DarioCapu/6610_proyecto/Proteus/Clase B/ClaseB_PCB.png

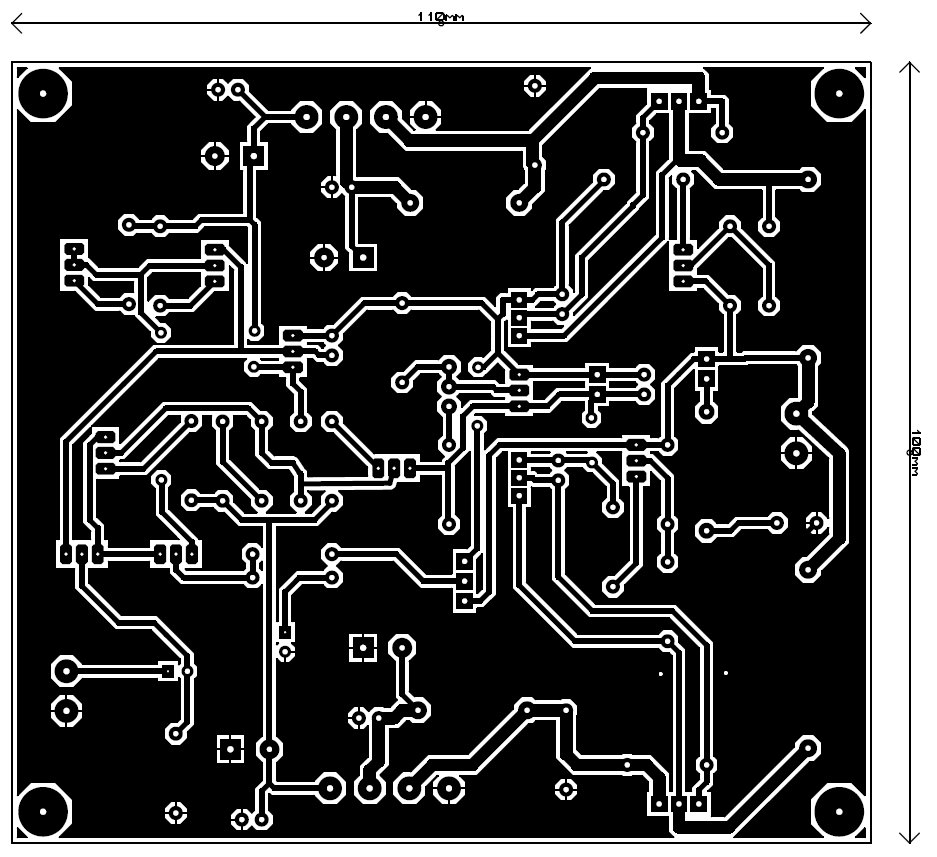
Proteus/Clase B/ClaseB_PCB.png
