DarioCapu/6610_proyecto/Proteus/Clase B/ClaseB_v4.bmp

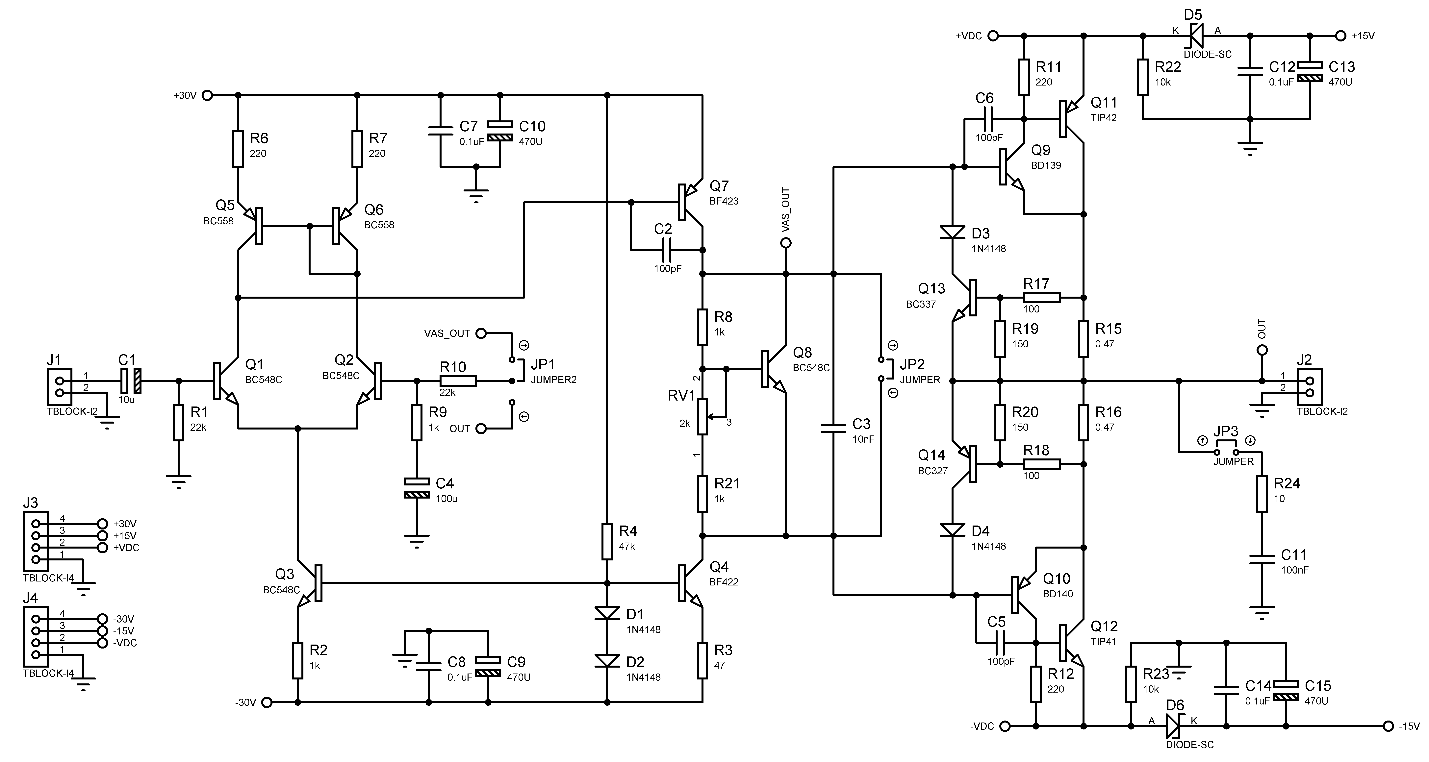
Proteus/Clase B/ClaseB_v4.bmp
