DarioCapu/6610_proyecto/Proteus/Regulador/Regulador_circuito.bmp

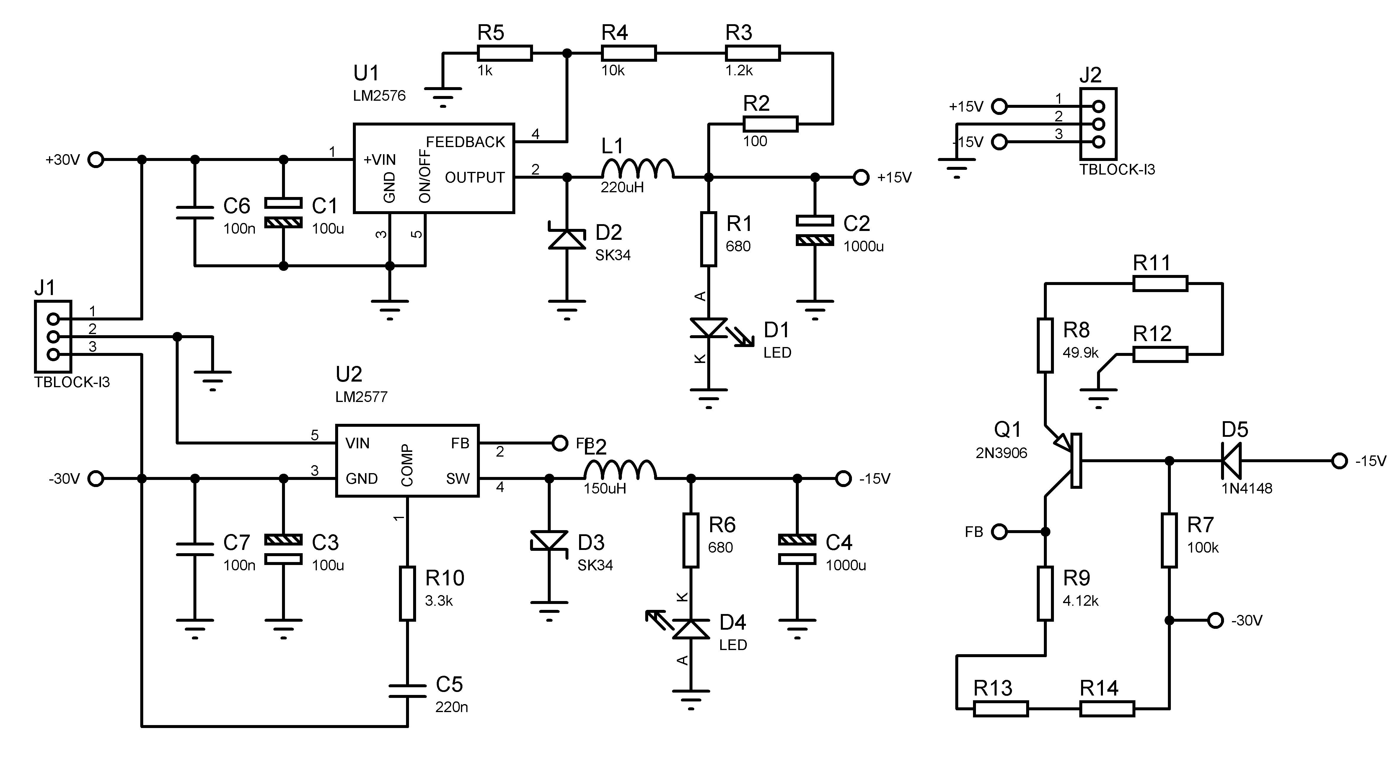
Proteus/Regulador/Regulador_circuito.bmp
