DarioCapu/6610_proyecto/Simulaciones/03_Clase_B_op.png

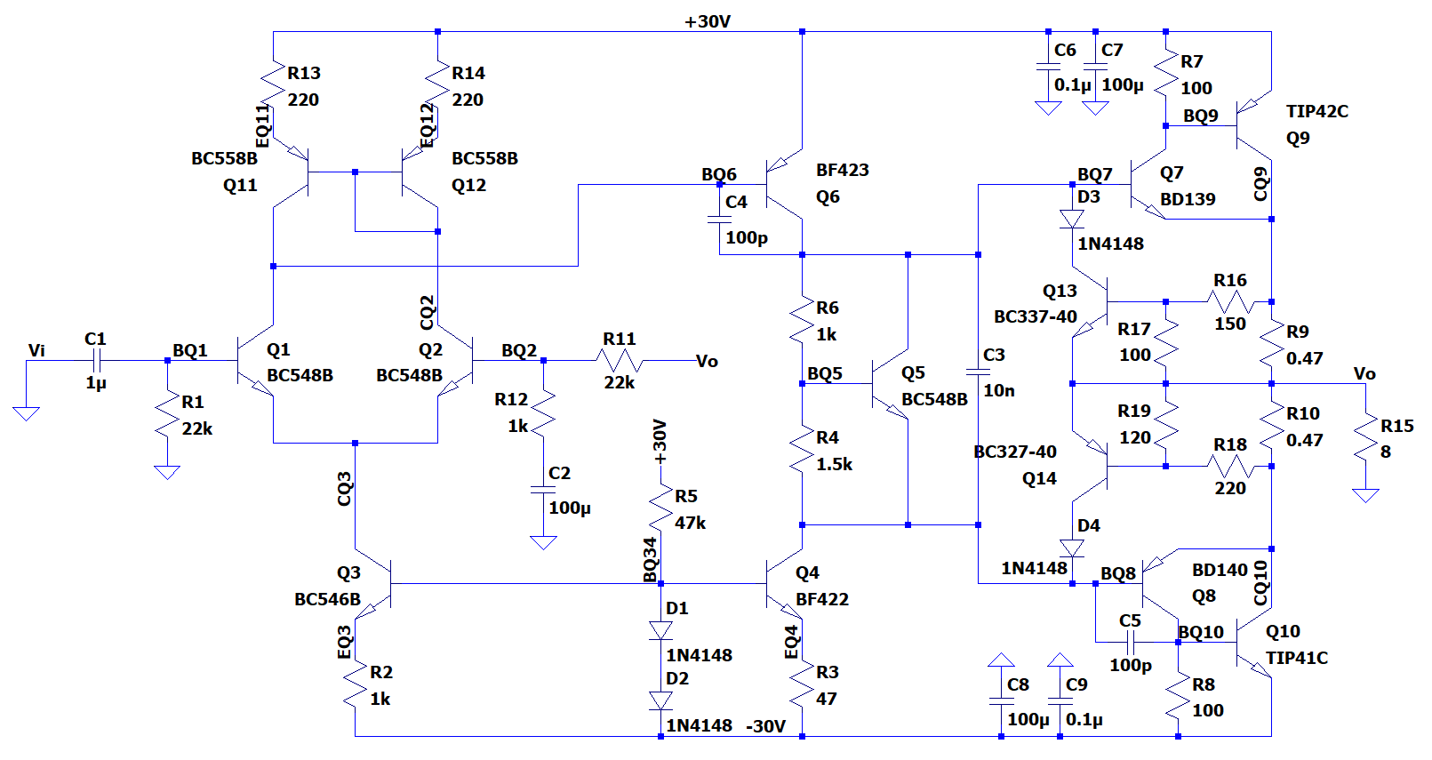
Simulaciones/03_Clase_B_op.png
