DarioCapu/6610_proyecto/Simulaciones/04_Sen_10mV_1kHz.png

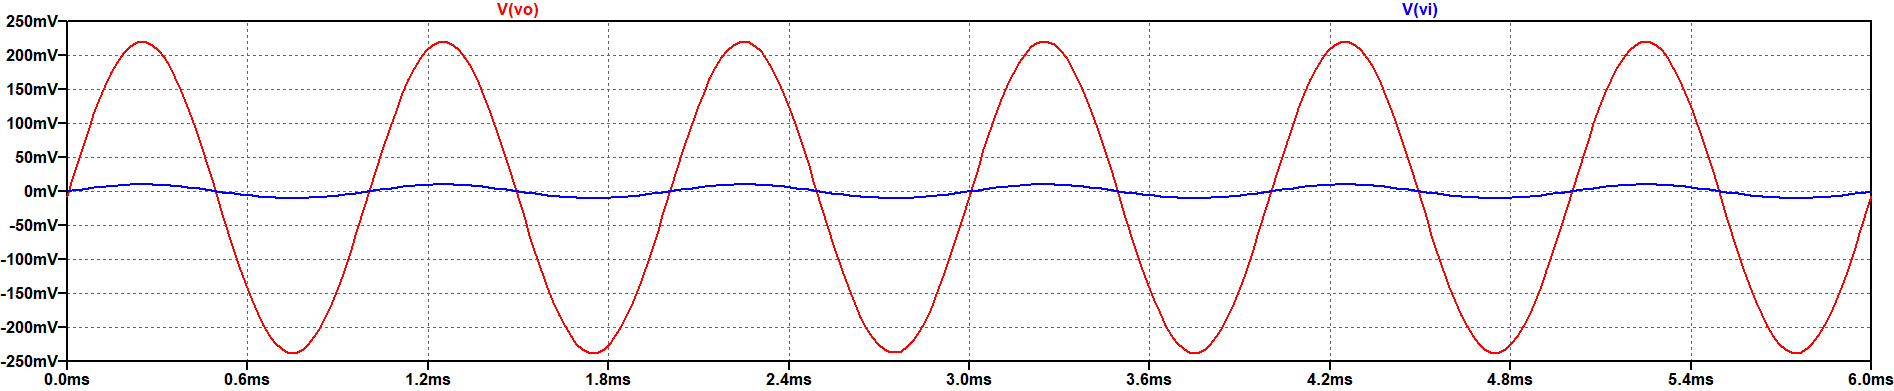
Simulaciones/04_Sen_10mV_1kHz.png
