DarioCapu/6610_proyecto/Simulaciones/10_Cuad_10mV_1kHz.png

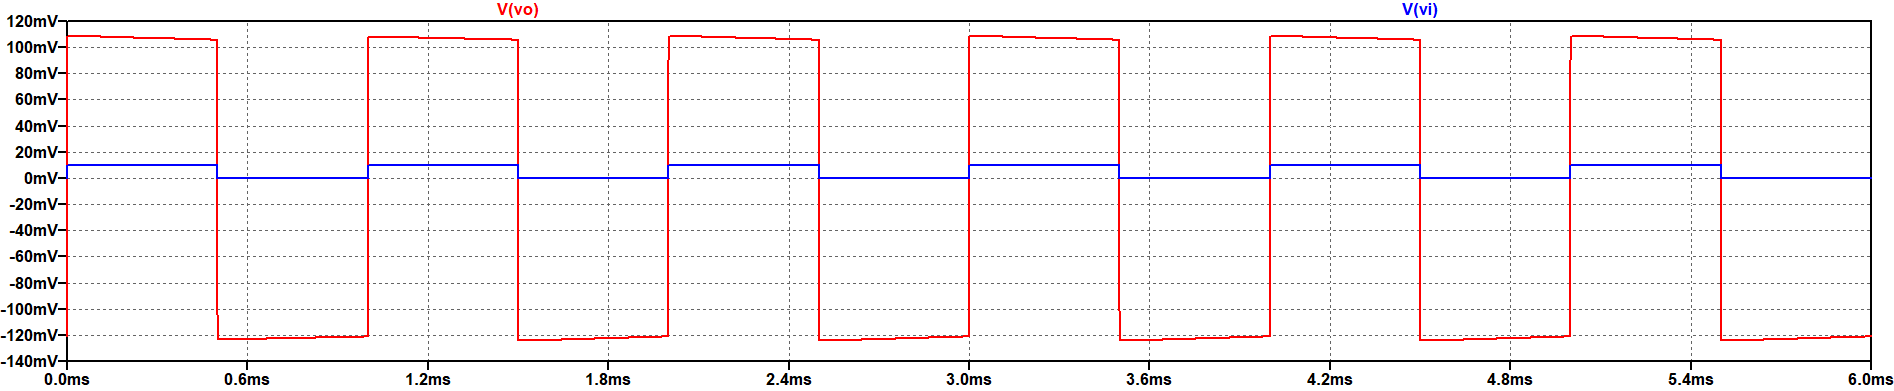
Simulaciones/10_Cuad_10mV_1kHz.png
