DarioCapu/6610_proyecto/Simulaciones/16_BW_clase_B.png

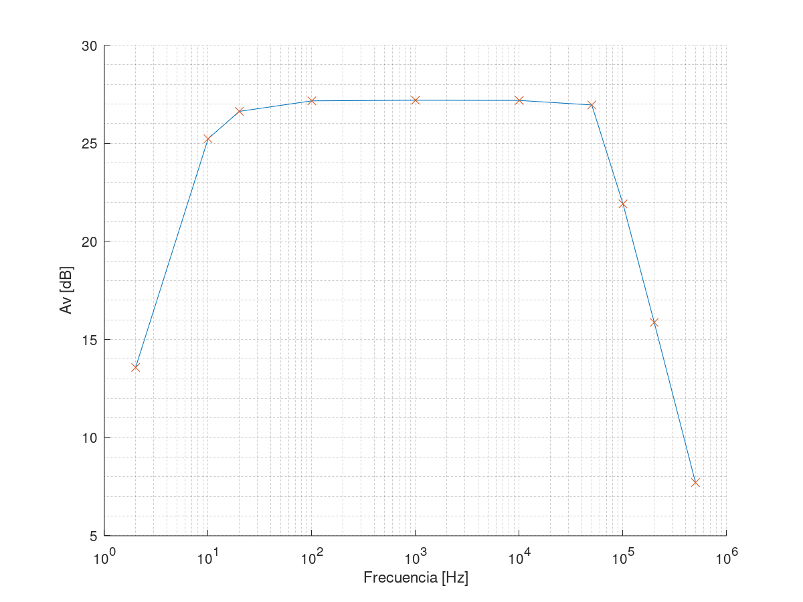
Simulaciones/16_BW_clase_B.png
