DarioCapu/6610_proyecto/Simulaciones/17_Ri_simulada.png

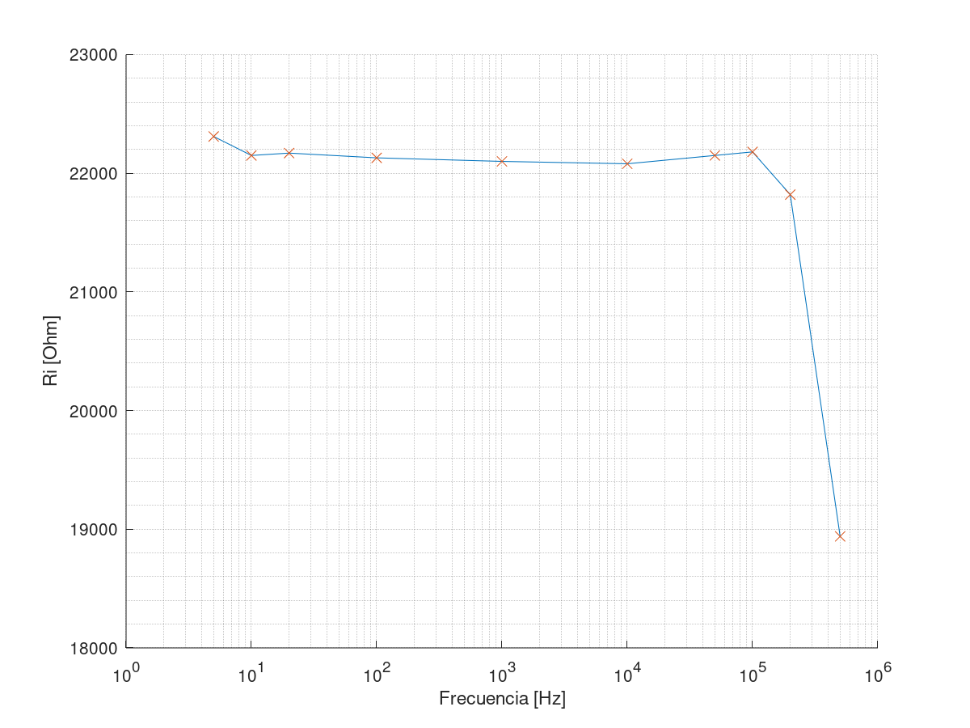
Simulaciones/17_Ri_simulada.png
