DarioCapu/6610_proyecto/Simulaciones/18_Ro_simulada.png

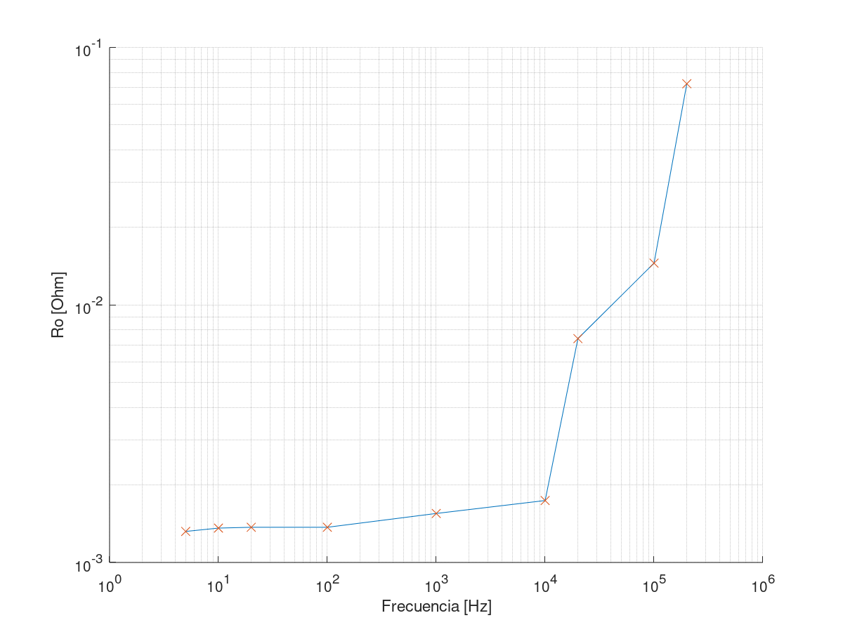
Simulaciones/18_Ro_simulada.png
