DarioCapu/6610_proyecto/Simulaciones/19_THD_simulada.png

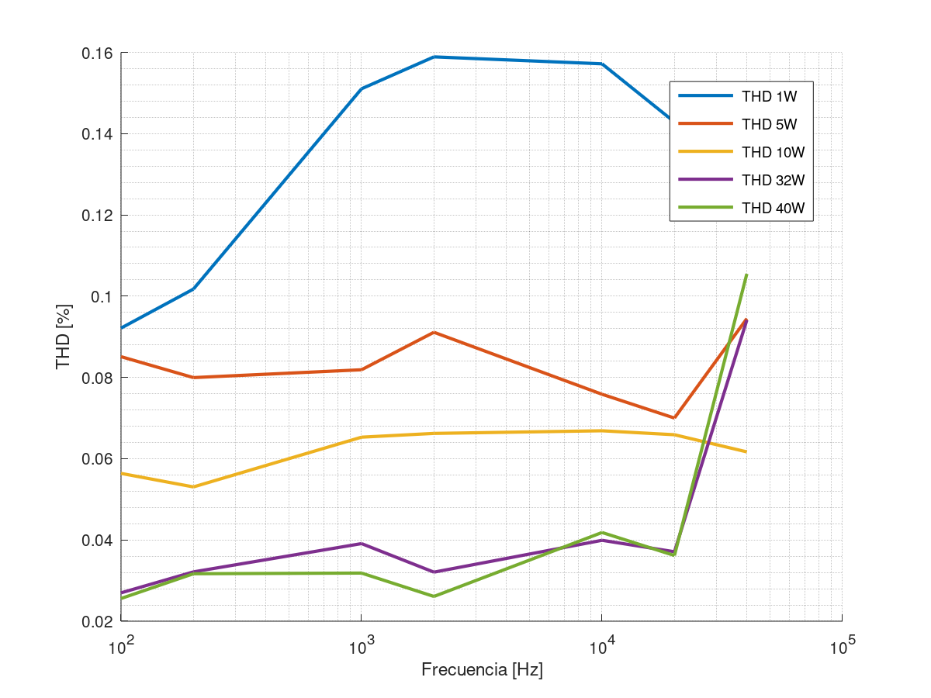
Simulaciones/19_THD_simulada.png
