DarioCapu/6610_proyecto/Simulaciones/30_vo_sin_recorte.png

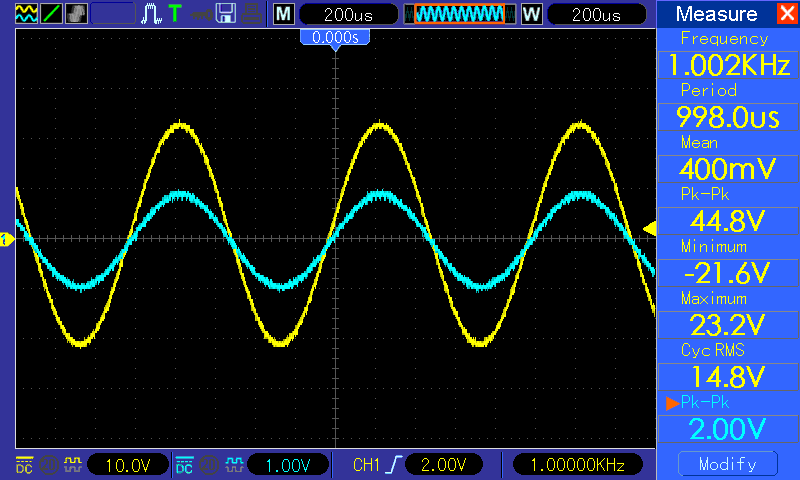
Simulaciones/30_vo_sin_recorte.png
