DarioCapu/6610_proyecto/Simulaciones/31_vo_con_recorte.png

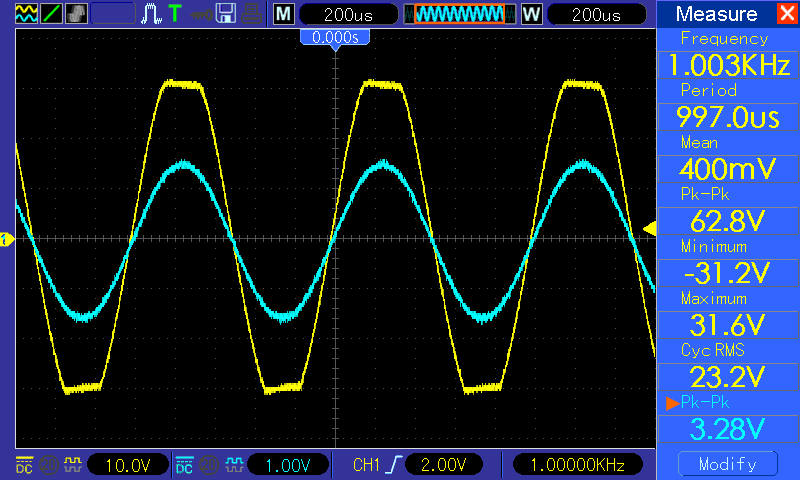
Simulaciones/31_vo_con_recorte.png
