DarioCapu/6610_proyecto/Simulaciones/34_Ganancia_medida_1.png

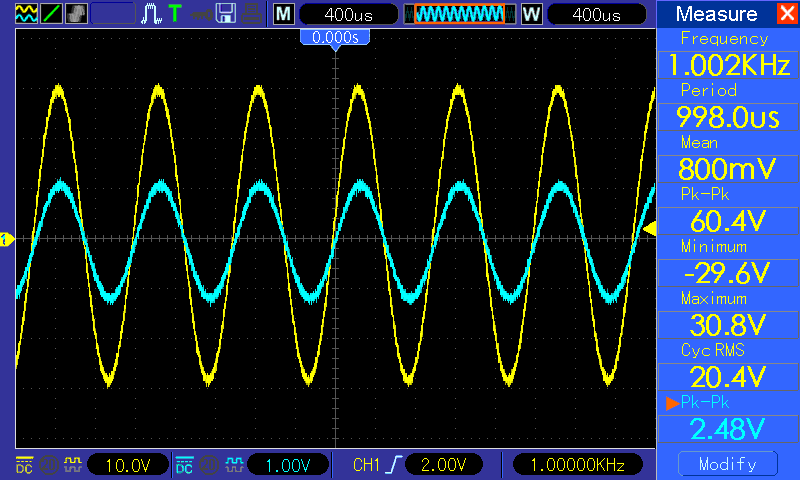
Simulaciones/34_Ganancia_medida_1.png
