DarioCapu/6610_proyecto/Simulaciones/70_Regulador_PCB.png

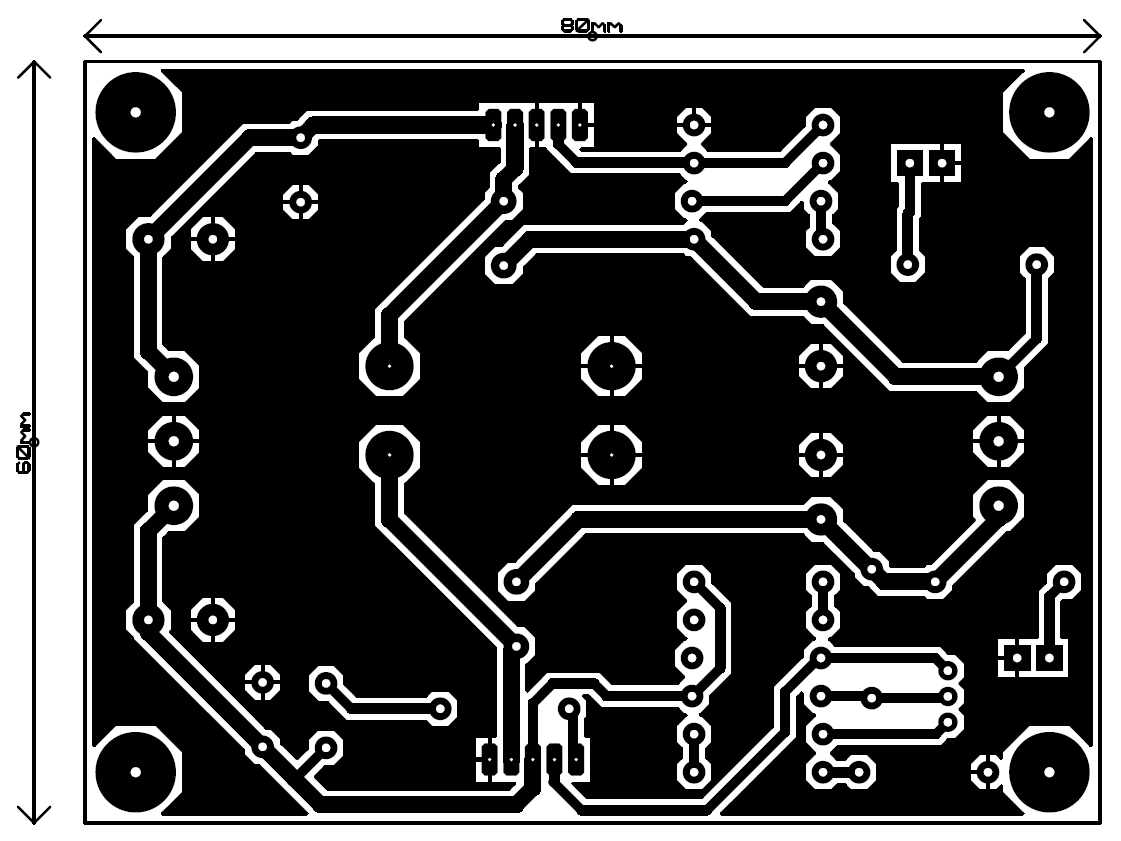
Simulaciones/70_Regulador_PCB.png
