DarioCapu/6610_proyecto/Proteus/Clase B/ClaseB_v4_PCB.PDF

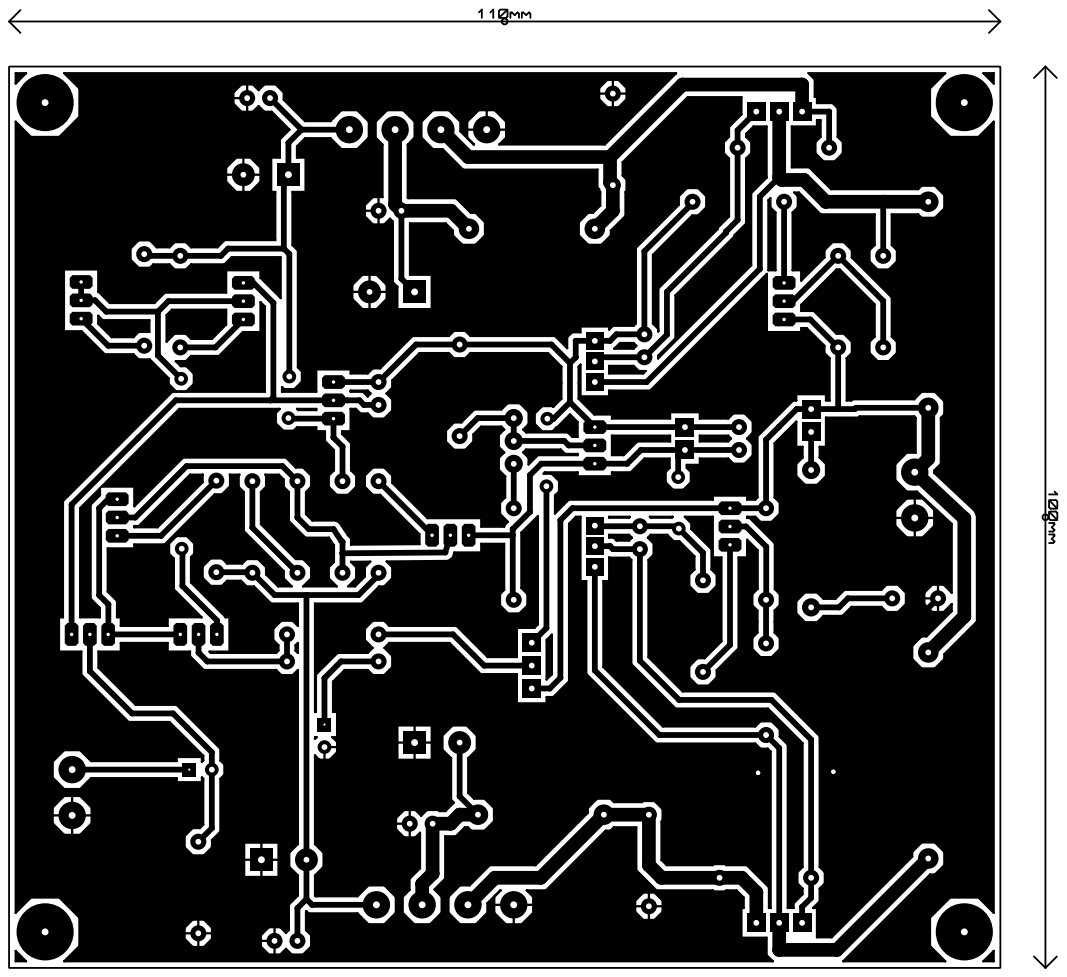
[picture p16: page 1]
