DarioCapu/6610_proyecto/Proteus/Regulador/Regulador.PDF

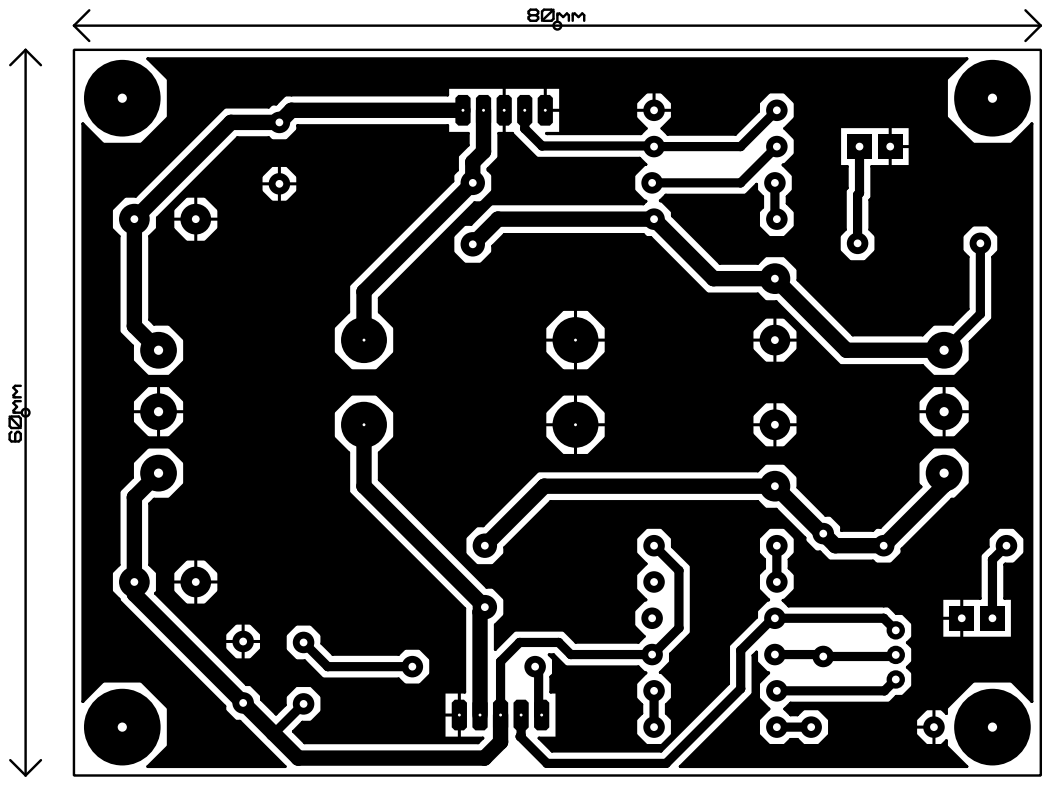
[picture p17: page 1]
