DarioCapu/6610_proyecto/Spice/ClaseB/Clase_B_v3.asc

C1: cap; 10µ
C2: cap; 100µ
C3: cap; 10n
C4: cap; 100p
C5: cap; 100p
C6: cap; 0.1µ
C7: cap; 100µ
C8: cap; 100µ
C9: cap; 0.1µ
D1: diode; 1N4148
D2: diode; 1N4148
D3: diode; 1N4148
D4: diode; 1N4148
Q1: npn; BC548B
Q2: npn; BC548B
Q3: npn; BC546B
Q4: npn; BF422
Q5: npn; BC548B
Q6: pnp; BF423
Q7: npn; BD139
Q8: pnp; BD140
Q9: pnp; TIP42C
Q10: npn; TIP41C
Q11: pnp; BC558B
Q12: pnp; BC558B
Q13: npn; BC337-40
Q14: pnp; BC327-40
R1: res; 22k
R2: res; 1k
R3: res; 47
R4: res; 1.3k
R5: res; 47k
R6: res; 1k
R7: res; 100
R8: res; 100
R9: res; 0.47
R10: res; 0.47
R11: res; 22k
R12: res; 1k
R13: res; 220
R14: res; 220
R15: res; 8
R16: res; 150
R17: res; 100
R18: res; 220
R19: res; 120
V1: voltage; 30V
V2: voltage; 30V
V3: signal; PULSE(0 1 0 1n 1n {T/2} {T})
Named nets: 0, +30V, -30V, Vo, Vi, BQ6, CQ3, EQ3, BQ34, EQ4, BQ7, BQ8, BQ9, BQ10, CQ10, CQ9, EQ11, EQ12, CQ2, BQ2, BQ1, BQ5
.inc standard_tbj.lib
;four {F} V(Vo)
.param F=1k T=1/F STOP=20*T START=STOP-6*T
.tran 0 1 0.994
.option noopiter
