DarioCapu/6610_proyecto/Spice/ClaseH/Clase_H.asc

BC337-40: npn
C1: cap; 100p
C2: cap; 10n
C3: cap; 1µ
C4: cap; 100p
C5: cap; 100µ
D1: schottky; 1N5819
D2: schottky; MBRS360
D3: schottky; MBRS360
D4: diode; D1N4742
D5: diode; 1N4148
D6: schottky; 1N5819
D7: diode; D1N4742
D8: diode; 1N4148
D9: diode; 1N4148
D10: diode; 1N4148
M2: nmos; IRF530
M3: pmos; IRF9640
Q1: pnp; TIP42C
Q2: npn; BD139
Q3: npn; TIP41C
Q4: pnp; BD140
Q5: npn; BC548B
Q6: pnp; BC327-40
Q10: npn; BD135
Q11: pnp; BD136
Q12: pnp; BC558B
Q13: pnp; BC558B
Q14: npn; BC548B
Q15: npn; BC548B
Q16: npn; BC546B
R1: res; 10k
R2: res; 1.8k
R3: res; 100k
R4: res; 0.47
R5: res; 0.47
R6: res; 100
R7: res; 100
R8: res; 1k
R9: res; 1.5k
R10: res; 1k
R11: res; 100k
R12: res; 10k
R13: res; 10k
R14: res; 10k
R15: res; 47
R16: res; 1k
R17: res; 100
R18: res; 1k
R19: res; 220
R20: res; 100
R21: res; 220
R22: res; 1K
R23: res; 47k
R24: res; 1k
R25: res; 22k
R26: res; 22k
R27: res; 150
R28: res; 150
Rl: res; 8
U3: LM311
U4: LM311
V1: voltage; 15V
V2: voltage; 15V
V3: voltage; 15V
V4: voltage; 15V
V5: voltage; SINE(0 1 {F})
Named nets: 0, +30V, -30V, +15V, +VLO, -VLO, -15V, Vo, VAS+, VAS-, Vi, cq3
.tran 0 {STOP} {START}
.lib diodos_2.lib
.lib standard_tbj.LIB
.param F=1k T=1/F STOP=20*T START=STOP-6*T
