DarioCapu/6610_proyecto/(list of files, drawings)

Other design files:
Proteus/Clase B/ClaseB_v4.pdsprj
Proteus/Clase B/ClaseB_x0.pdsprj
Proteus/Conmutacion/Conmutacion_02_2019.pdsprj
Proteus/Regulador/Regulador.pdsprj
