DarioCapu/6610_proyecto/(commit log)

2019-10-16 Primer commit
    [ClaseB_x0.pdsprj]
2019-10-17 Regulador corregido
    [Regulador.pdsprj]
2019-10-17 Agregando etapa de conmutación
    [Conmutacion_02_2019.pdsprj]
2019-11-13 Regulador nuevo
    [Regulador.pdsprj]
2019-12-05 Cosas nuevas
    [Regulador.pdsprj]
2019-12-10 Mas Cosas nuevas
    [ClaseB_v4.pdsprj]
